ITDiscovery/AdjBedController/BetterMotorDriverSchematic.png

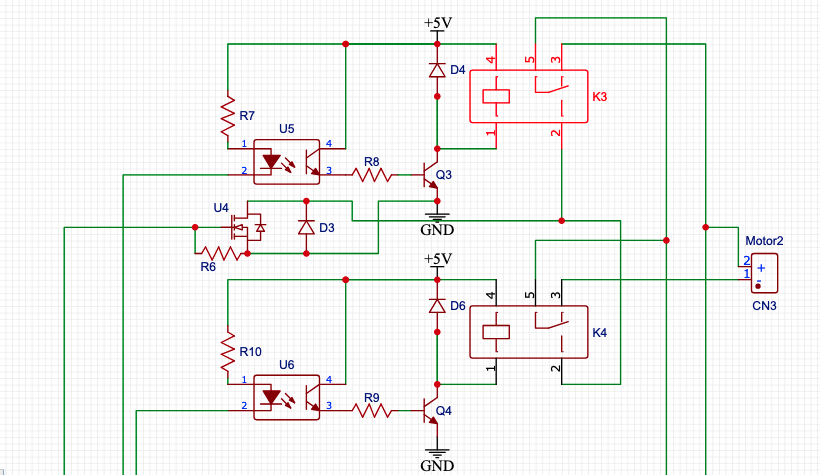
BetterMotorDriverSchematic.png
