ITDiscovery/AdjBedController/Schematic_OpenSource-Adjustable-Bed-Motor-Driver_2024-11-03.pdf

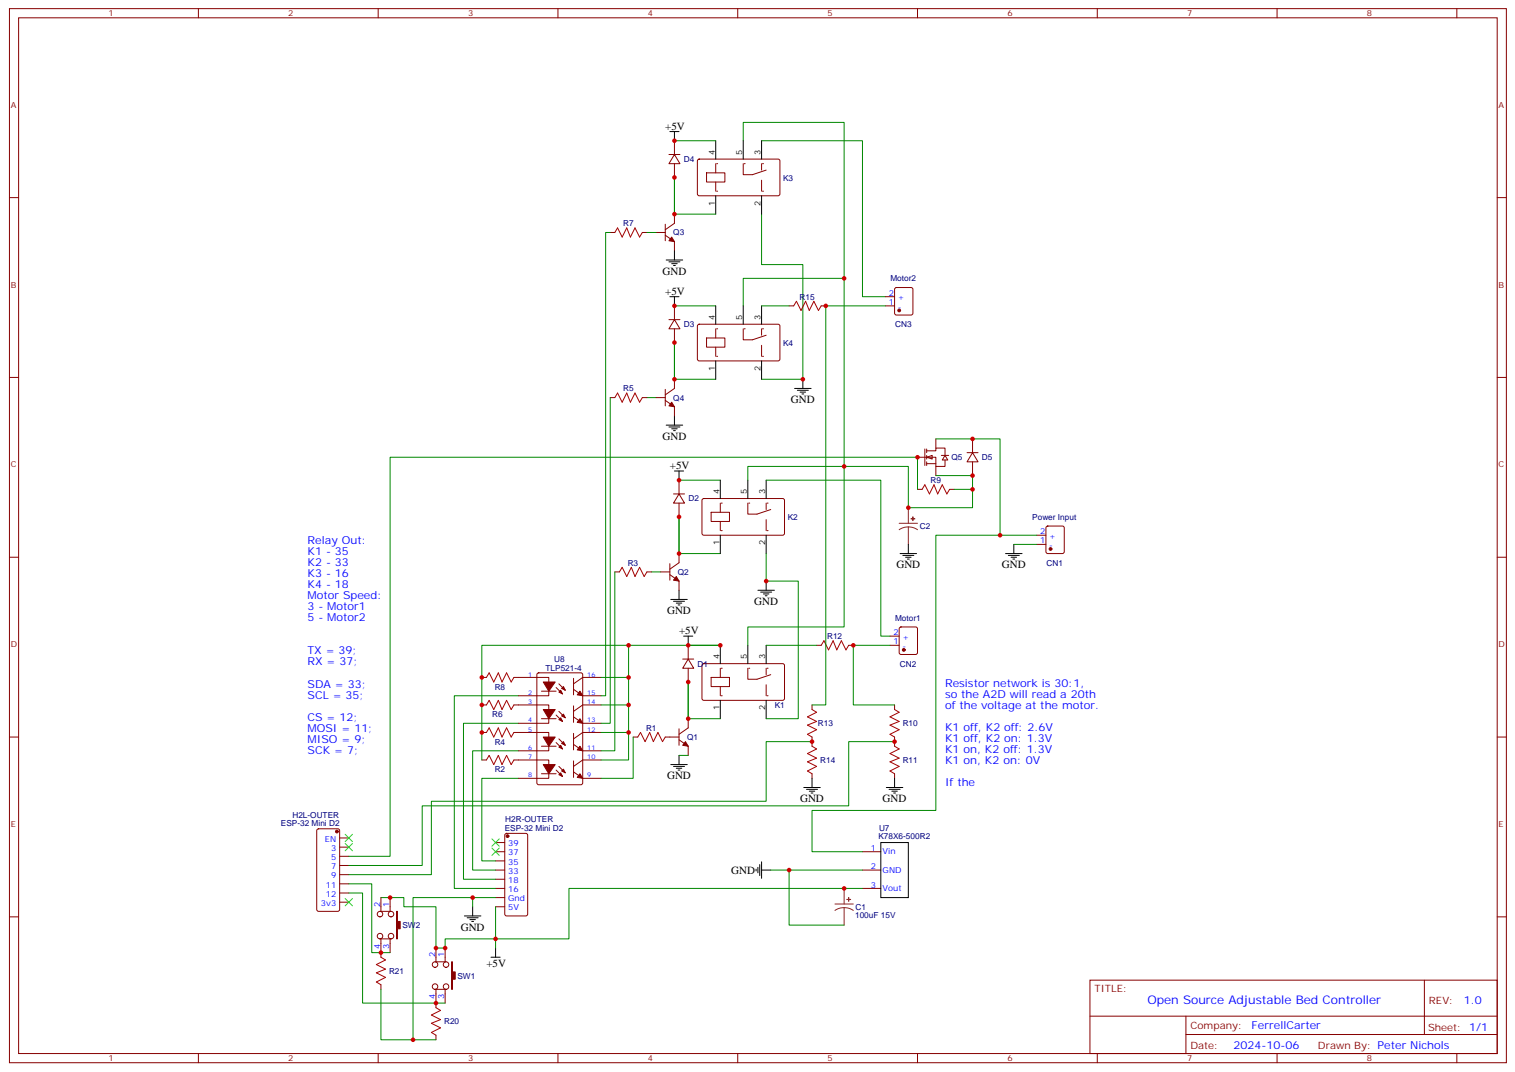
[picture p13: page 1]

Resistor network is 30:1,
so the A2D will read a 20th
of the voltage at the motor.
K1 off, K2 off: 2.6V
K1 off, K2 on: 1.3V
K1 on, K2 off: 1.3V
If the

Drawn By: Peter Nichols
