ITDiscovery/AdjBedController/AdjBedDriverPCBv2.pdf

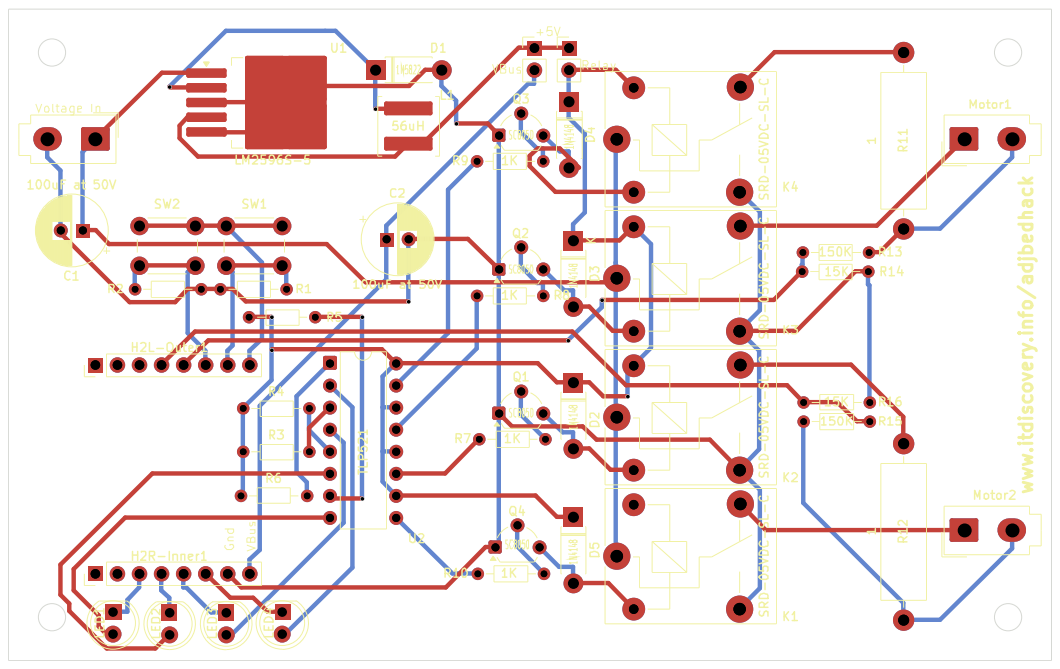
[picture p14: page 1]
