ITDiscovery/AdjBedController/AdjBedDriverv2.pdf

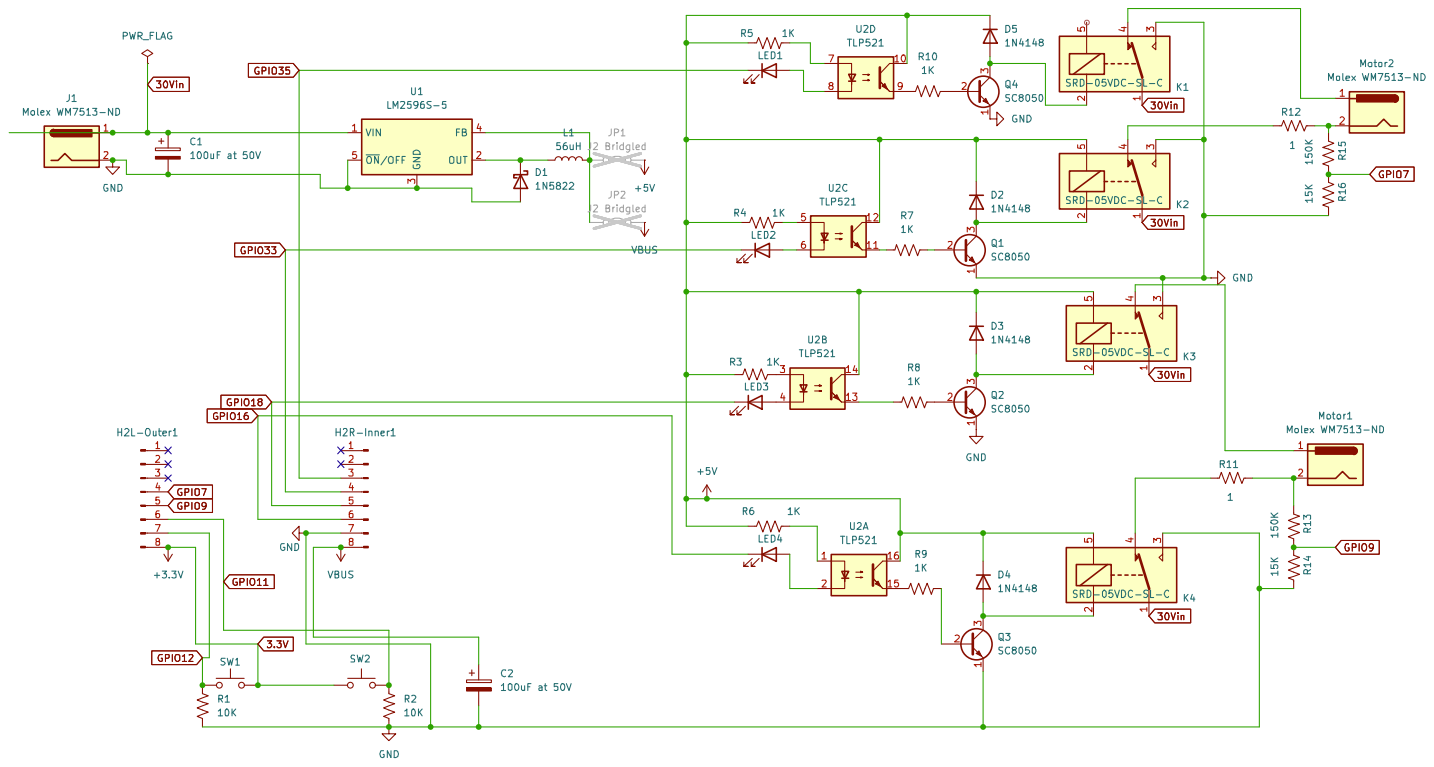
[picture p15: page 1]
