ITDiscovery/AdjBedController/(commit log)

2024-11-03 Note about shunt resistor
2024-11-03 Motor Simulation
2025-03-16 Adding Schematic and PCB Layout
    Will add Gerber once boards are tested.
